daveharrisuk/CANlights/CANlights testCable module.jpg

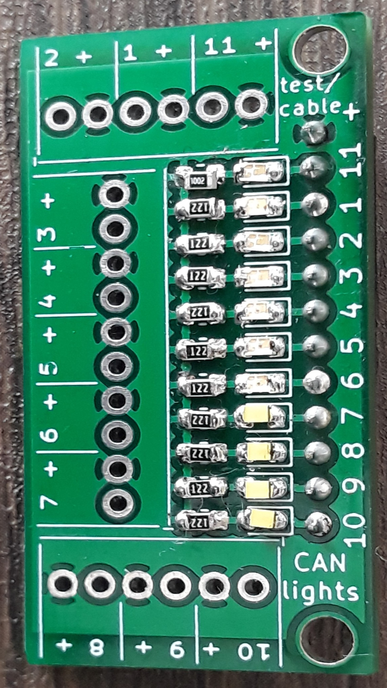
CANlights testCable module.jpg
