daveharrisuk/CANlights/CANlights PCB revC.png

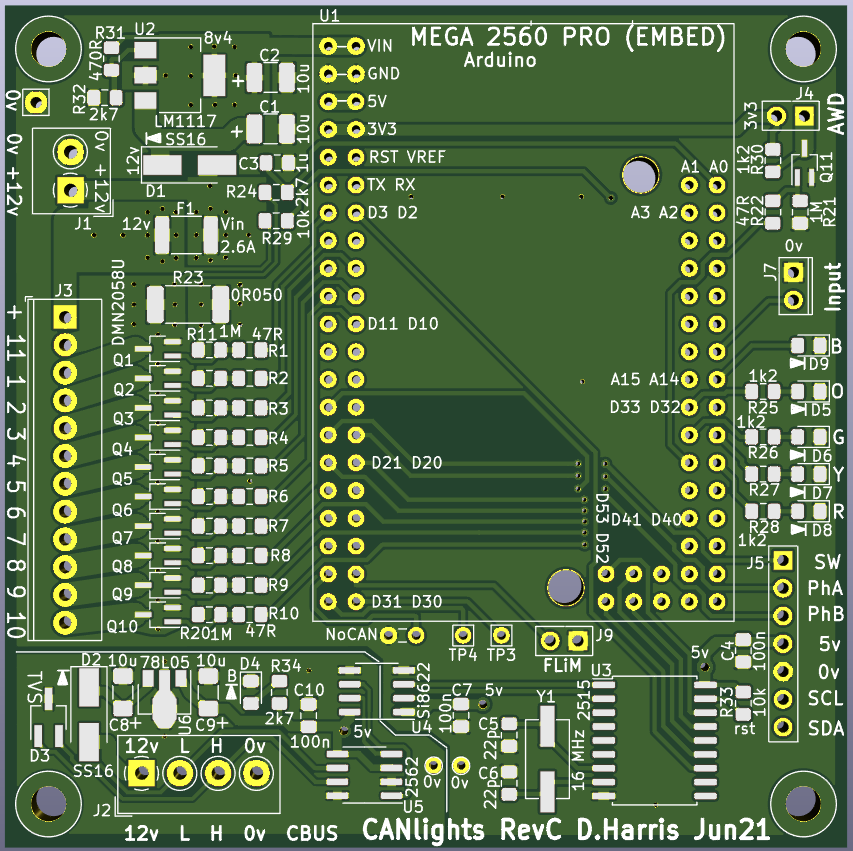
CANlights PCB revC.png
