daveharrisuk/CANlights/DayNight levels.png

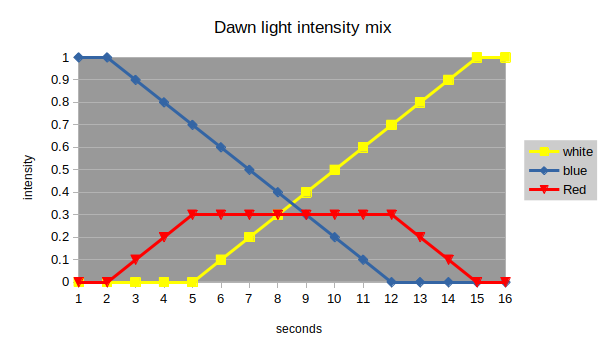
DayNight levels.png
