daveharrisuk/CANlights/BOM.ods

Sheet: parts
Farnell | Order 79213245 25-Jan-2021. Bulk buy, enough for 10 modules plus spares. |  |  |  |  |  | Per Module
Code | Description | Manufacturer | Manufacturer Part | Qty | Price | Total | Qty | cost
3122019 | Voltage Series Regulator, Adjustable, SMD SOT-223 | TEXAS | LM1117IMP-ADJ | 12 | 0.7833 | 9.40 | 1 | 0.78
3212602 | Piezo Buzzer, 3V, 4KHZ; 75dBA; TH | TDK | PS1740P02E | 10 | 0.516 | 5.16 | 1 | 0.52
2211848 | Opto coupler, DC, SMD SO6 (4 pin) | TOSHIBA | TLP185 | 15 | 0.256 | 3.84 | 1 | 0.26
3405172 | MOSFET, N-CH, 20V, 3.5A, 0.5W; SMD SOT-323 | DIODES INC | DMN2058UW-7 | 120 | 0.0861 | 10.33 | 11 | 0.95
1740673 | Ceramic cap 100 nF, 50V X7R, SMD 0805 | AVX | 08055C104JAT2A | 30 | 0.095 | 2.85 | 1 | 0.10
3013472 | Ceramic cap 10 nF, 50 V X7R, SMD 0805 | SAMSUNG | CL21B103KCANNNC | 40 | 0.0255 | 1.02 | 3 | 0.08
1754086 | Tantalum cap 10µF, 16V, SMD 1206 | VISHAY | TR3A106K016C1700 | 20 | 0.446 | 8.92 | 2 | 0.89
1861170 | Resettable Fuse, SMD 1812, 12 VDC 1.5 A hold, 3 A trip | MULTICOMP | MC36231 | 15 | 0.116 | 1.74 | 1 | 0.12
2828288 | Resistor, 0R050, 2 W, SMD 2512 | MULTICOMP | MCLRP12FTWSR050 | 20 | 0.227 | 4.54 | 1 | 0.23
2447666 | Resistor, 47R, 125 mW, SMD 0805 | MULTICOMP | MCWR08X47R0FTL | 110 | 0.0061 | 0.67 | 11 | 0.07
2447618 | Resistor, 270R, 125 mW, SMD 0805 | MULTICOMP | MCWR08X2700FTL | 50 | 0.0072 | 0.36 | 1 | 0.01
2447662 | Resistor, 470R, 125 mW, SMD 0805 | MULTICOMP | MCWR08X4700FTL | 50 | 0.0064 | 0.32 | 1 | 0.01
2447587 | Resistor, 1k0, 125 mW, SMD 0805 | MULTICOMP | MCWR08X1001FTL | 50 | 0.0072 | 0.36 | 1 | 0.01
2447627 | Resistor, 2k7, 125 mW, SMD 0805 | MULTICOMP | MCWR08X2701FTL | 50 | 0.007 | 0.35 | 3 | 0.02
2447672 | Resistor, 4k7, 125 mW, SMD 0805 | MULTICOMP | MCWR08X4701FTL | 50 | 0.0072 | 0.36 | 1 | 0.01
2447553 | Resistor, 10k, 125 mW, SMD 0805 | MULTICOMP | MCWR08X1002FTL | 100 | 0.006 | 0.60 | 7 | 0.04
3234222 | Standard Recovery Diode, SMD DO-214 (SMA), 1 A | MULTICOMP | 1N4007 | 10 | 0.184 | 1.84 | 1 | 0.18
1675764 | Pin Header, 2.54 mm 2 way , MC34, TH Straight | MULTICOMP | MC34629 | 50 | 0.0154 | 0.77 | 1 | 0.02
1675754 | Connector Housing, 2.54 mm 2 Way (MC34 2218T contact) | MULTICOMP | MC34481 | 50 | 0.0176 | 0.88 | 1 | 0.02
3226076 | Shunt socket, for 2.54 mm header, 2 way | HARWIN | M7581-46 | 100 | 0.0456 | 4.56 | 2 | 0.09
2493646 | Terminal screw block, pluggable, 3.5mm; 2 way | CAMDENBOSS | CTB922HD/2 | 10 | 0.449 | 4.49 | 1 | 0.45
1841308 | Terminal block header, 3.5mm, 2 way, TH | WURTH | 691321100002 | 10 | 0.225 | 2.25 | 1 | 0.23
2847167 | Pin Header, 2.54 mm, 1 row, 22 way, TH | MULTICOMP | 2211S-22G | 40 | 0.114 | 4.56 | 2 | 0.23
1581242 | LED, SMD 0805 Green | MULTICOMP | MCL-S270GC | 10 | 0.085 | 0.85 | 1 | 0.09
1581241 | LED, SMD 0805 Yellow | MULTICOMP | MCL-S270YC | 10 | 0.091 | 0.91 | 1 | 0.09
1581239 | LED, SMD 0805 Red | MULTICOMP | MCL-S270SRC | 10 | 0.088 | 0.88 | 1 | 0.09
2217980 | LED, SMD 0805 Blue | KINGBRIGHT | KPT-2012QBC-D | 10 | 0.218 | 2.18 | 1 | 0.22
 |  |  |  | order total |  | 74.99 | sub t | 5.76
Other items |  |  |  | VAT | 15.0% | 11.25 | VAT | 0.86
 |  |  |  |  |  | 86.24 | sub t | 6.62
 | Mega 250 PRO (EMBED) {can be had cheaper from China} | eBay UK supplier ‘FamStore’ st-8078 |  | 6 | 9.83 | 58.98 | 1 | 9.83
 | Lights_Control PCB | JLCPCB |  | 10 | 1.604 | 16.04 | 1 | 1.60
 |  |  |  |  |  |  | total | 18.06

Sheet: Sheet2
CANlights revB BOM
ref | part | package | Qty | Manufacturer | Mouser | each | total
U1 | MEGA 2560 PRO (EMBED) |  | 1 |  | na | 10.50 | 10.50 | find a deal on ebay
PCB | 77mm x 77mm x 1.6mm |  | 1 | JLCPCB | na | 2.00 | 2.00 | Gerber file on github
U5 | MCP2562-E-SN | SOIC8 | 1 | MicroChip | 579-MCP2562FDT-E/SN | 0.77 | 0.77
U6 | 78L05 5v 100mA | SOT-89 | 1 | NJR | 513-NJM78L05SU3-TE1 | 0.26 | 0.26
U4 | Si8622BC-B-IS | SOIC8 | 1 | SiliconLabs | 634-SI8622BC-B-ISR | 0.95 | 0.95
U3 | MCP2515-I/SO | SOIC-18W | 1 | MicroChip | 579-MCP2515-I/SO | 1.48 | 1.48
U2 | LM1117-ADJ | SOT-223 | 1 | OnSemi | 863-LM1117MPXADJNOPB | 0.37 | 0.37
Q1–11 | DMN2058U | SOT-323 | 11 | DiodesInc | 621-DMN2058UW-13 | 0.21 | 2.31
D1, 2 | SS16-E3 | SMA | 2 | Vishay | 625-SS16-E3 | 0.18 | 0.36
D3 | ESDCAN06-2 | SOT-23W | 1 | STM | 511-ESDCAN06-2BWY | 0.24 | 0.24
D4, 9 | LED Blue | 0805 | 2 | Wurth | 710-150080BS75000 | 0.14 | 0.28
D8 | LED Red | 0805 | 1 | Wurth | 710-150080RS75000 | 0.13 | 0.13
D6 +TM | LED Green | 0805 | 2 | Wurth | 710-150080GS75000 | 0.13 | 0.26
D7 | LED Yellow | 0805 | 1 | Wurth | 710-150080YS75000 | 0.13 | 0.13
D5 | LED Orange | 0805 | 1 | LiteOn | 859-LTST-C170KFKT | 0.15 | 0.15
C1, 2, 8, 9 | 10u Tantalum 16V | 1206 | 4 | AVX | 581-TAJA106K016TNJ | 0.14 | 0.56
C4, 7, 10 | 100n Ceramic 50V | 0805 | 3 | TaiyoYuden | 963-UMK212B7104MGHT | 0.06 | 0.18
C5, 6 | 18p Ceramic 50V | 0805 | 2 | Kemet | 80-C0805C180K5HACTU | 0.05 | 0.10
C3 | 1u Ceramic 50V | 0805 | 1 | Samsung | 187-CL21B105KBFNNNG | 0.09 | 0.09
R23 | 0R050 2.0 W | 2512 | 1 | Ohmite | 588-PCS2512DR0500ET | 0.38 | 0.38
R1-10, 22 | 47R 0.125W | 0805 | 11 |  | 71-RCG080547R0JNEA | 0.03 | 0.33
R31 | 470R 0.125W | 0805 | 1 |  | 652-CR0805FX-4700ELF | 0.03 | 0.03
R25-28, 30 | 1k2 0.125W | 0805 | 5 |  | 652-CR0805JW-122ELF | 0.03 | 0.15
R24, 29, 32 | 2k7 0.125W | 0805 | 2 |  | 71-CRCW0805-2.7K-E3 | 0.03 | 0.06
R33/34 | 10k 0.125W | 0805 | 2 |  |  | 0.03 | 0.06
R11-20, 21 | 1M 0.125W | 0805 | 11 |  | 667-ERA-6AED105V | 0.03 | 0.33
F1 | PPTC 2.6A/5.0A 13.2V | 1812 | 1 | BEL | 530-0ZCG0260AF2B | 0.17 | 0.17
Y1 | Crystal 16MHz ABLS7M2 | smd 7*4mm | 1 | Abracon | 815-ABLS7M216MHZD2YT | 0.22 | 0.22
AWD | piezoelectric passive sounder 4 kHz 3-5V |  | 1 | Murata | PKM13EPYH4002-B0 | 0.32 | 0.32 | hard wire or 2pin header
J1 | TH 3.5mm 2way Pluggable ST |  | 1 | Amphenol | 649-OQ02125003J0G | 0.15 | 0.15 | standard CBUS plug
J2 | TH 3.5mm 4way Pluggable RA |  | 1 | Amphenol | 649-220110-C041A01LF | 0.24 | 0.24
J3 | TH 2.54mm 12way header Molex KK |  | 1 | Molex | 538-22-23-2121 | 0.48 | 0.48
J3 housing | 2.54mm 12way housing Molex KK |  | 1 | Molex | 538-10-11-2124 | 0.30 | 0.30
J4, 9 | TH 2.54mm 9way header pin strip |  | 1 |  | 538-22-28-4090 | 0.24 | 0.24 | cut to size
Part numbers and prices as at Apr 2021 |  |  |  |  |  | total | 24.58
