daveharrisuk/CANlights/CANlights schematic v1-1.pdf

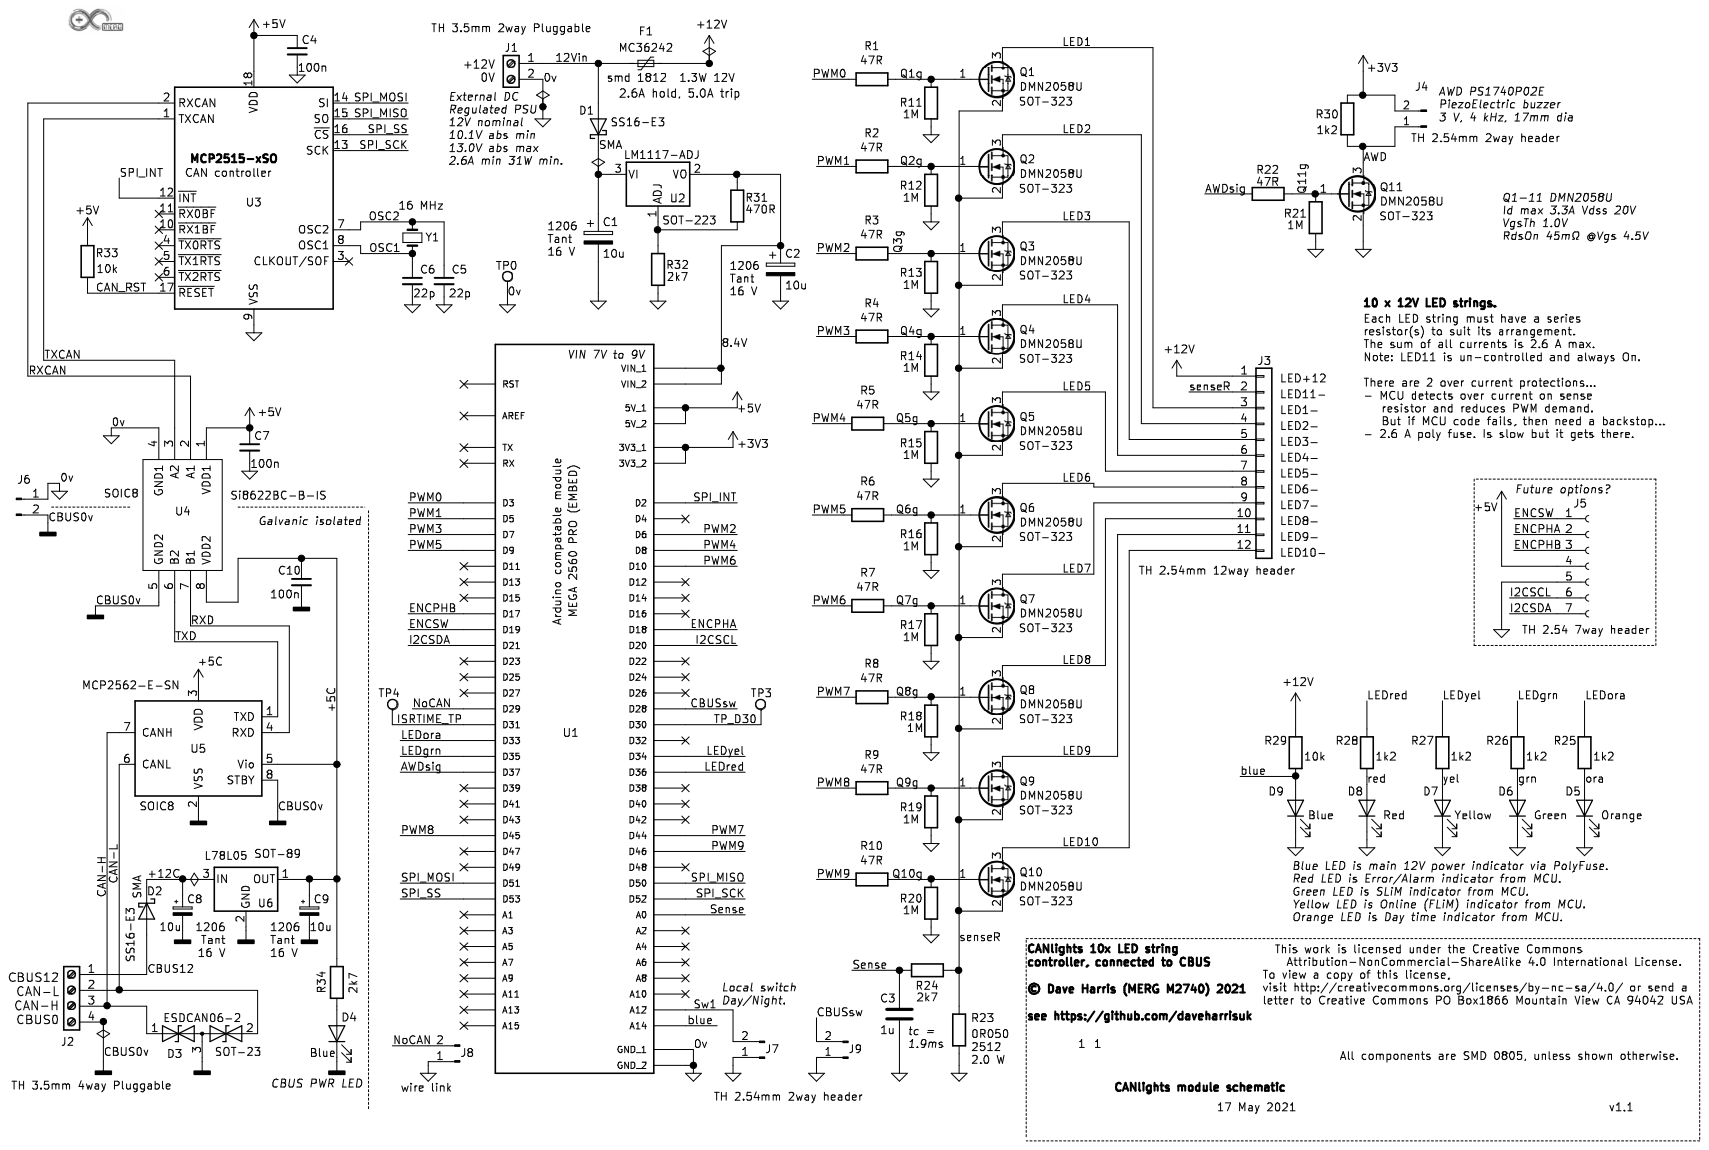
[picture p4: page 1]
