daveharrisuk/CANlights/CANlights PCB revC layout.pdf

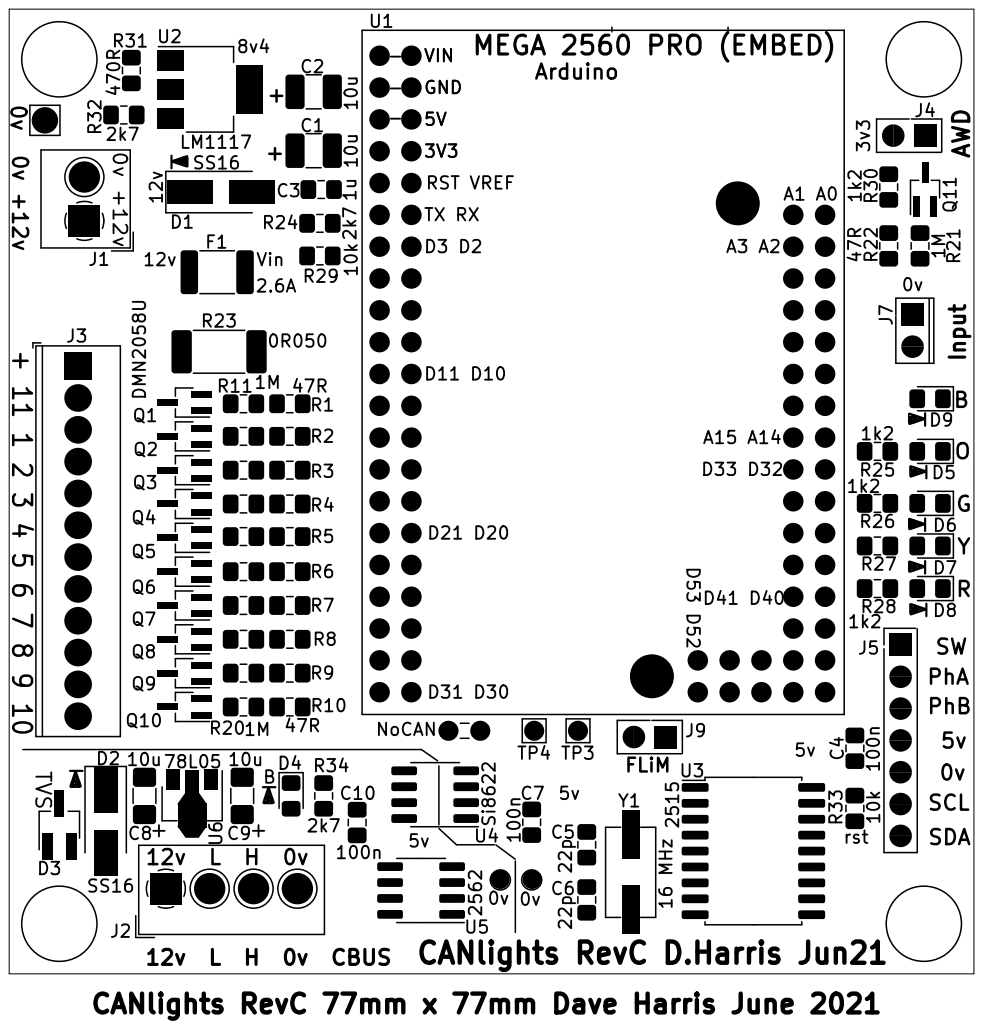
[picture p5: page 1]
